seb-ma/kevin/3d-components/SKRHAD.step

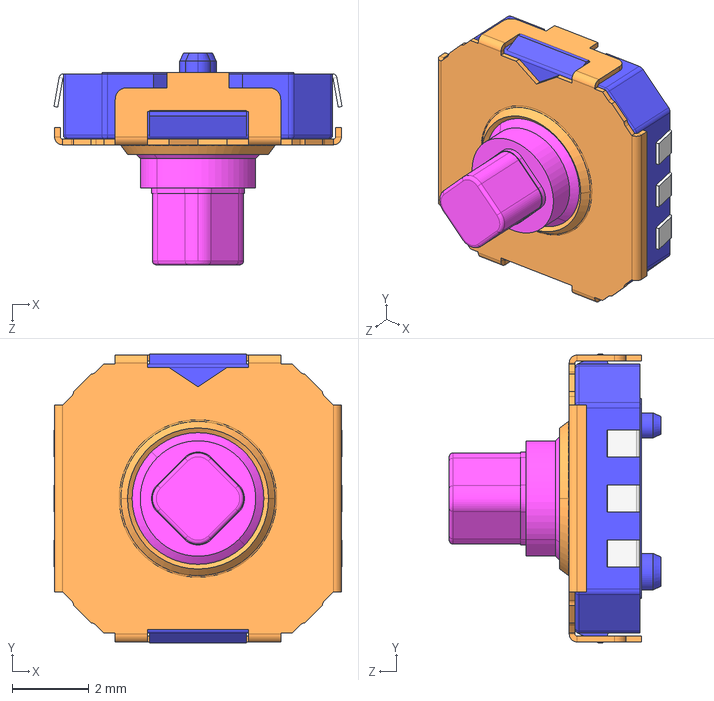
[picture p1: CAD file, 2021-09-05]
3d-components/SKRHAD.step
7.48 x 7.50 x 5.50 mm
