seb-ma/kevin/3d-components/SW_SPDT_CK-JS102011SAQN.step

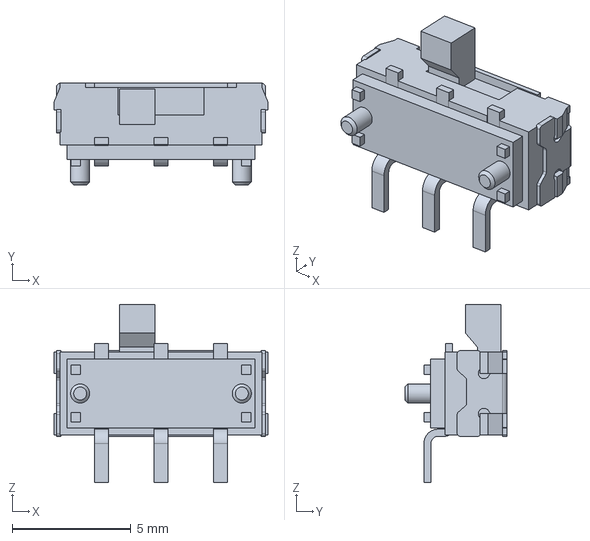
[picture p2: CAD file, 2021-09-05]
3d-components/SW_SPDT_CK-JS102011SAQN.step
9.00 x 4.30 x 7.50 mm
