seb-ma/kevin/3d-components/CON_MILL-MAX-810-22-008-40-001101.step

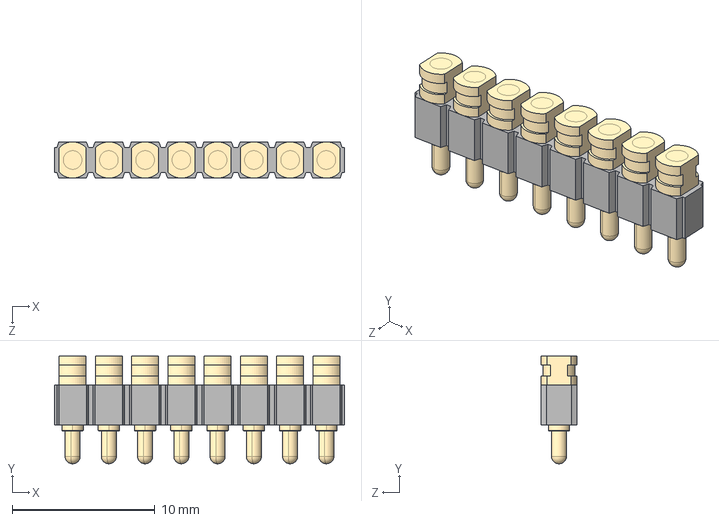
[picture p3: CAD file, 2021-09-05]
3d-components/CON_MILL-MAX-810-22-008-40-001101.step
20.3 x 7.54 x 2.54 mm
mill-max-810-22-008-40-001101_P3XX-18-010-00-090000_P308-18-010-00-090000
mill-max-810-22-008-40-001101_0916_default x 8
