seb-ma/kevin/3d-components/CON_HIROSE_FH12-30S-0_5SH_55_.step

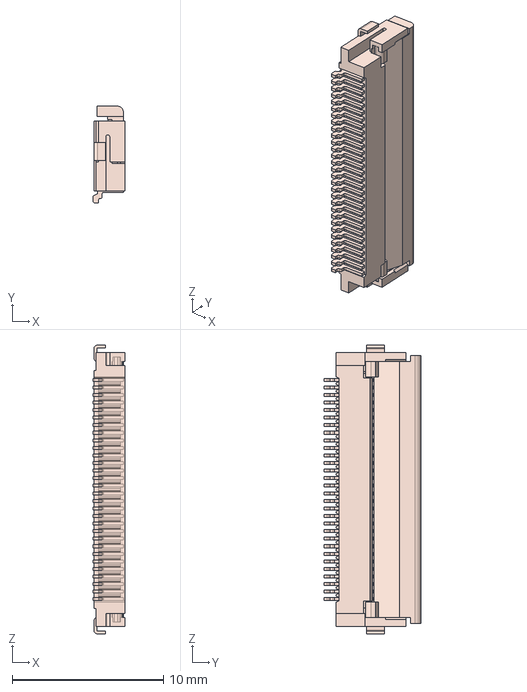
[picture p4: CAD file, 2021-09-05]
3d-components/CON_HIROSE_FH12-30S-0_5SH_55_.step
2.10 x 6.40 x 19.1 mm
