seb-ma/kevin/3d-components/CON_SM02B-SRSS-TB.step

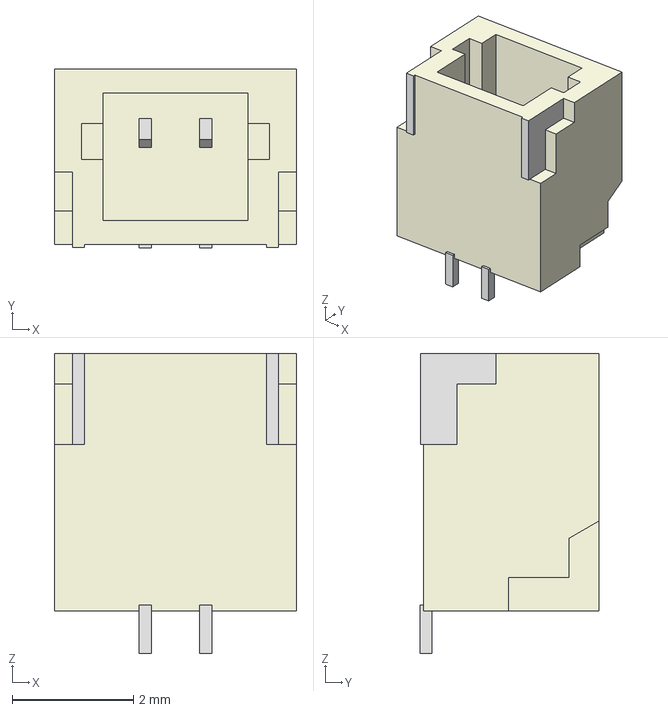
[picture p5: CAD file, 2021-09-05]
3d-components/CON_SM02B-SRSS-TB.step
4.00 x 2.96 x 4.95 mm
