seb-ma/kevin/3d-components/CON_MOLEX_2005280040.step

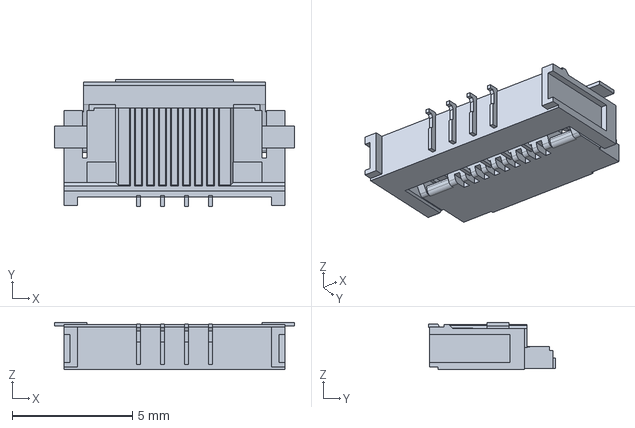
[picture p6: CAD file, 2021-09-05]
3d-components/CON_MOLEX_2005280040.step
10.0 x 5.30 x 1.96 mm
