seb-ma/kevin/3d-components/CON_MILL-MAX-319-10-108-40-080001.step

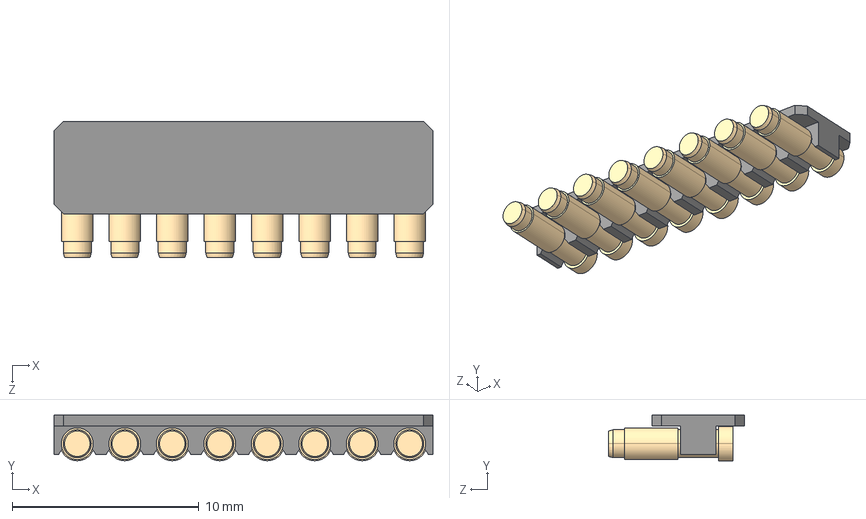
[picture p7: CAD file, 2021-09-05]
3d-components/CON_MILL-MAX-319-10-108-40-080001.step
20.3 x 2.44 x 7.29 mm
mill-max-319-10-108-40-080001_P8XX-18-083-00-400155_P808-18-083-00-400155
mill-max-319-10-108-40-080001_1980_1980-0-00-15-00-00-03-0 x 8
