seb-ma/kevin/(commit log)

2021-07-27 First commit to share
    [kevin.kicad_pcb, kevin.sch]
2021-07-30 Prepare reversible matrix (kailth pg1350 and diode footprints) Routing e-ink reset to mcu Keys placement
    [kevin.kicad_pcb, kevin.sch]
2021-07-31 General cleaning
    [kevin.kicad_pcb, kevin.sch]
2021-08-19 prepare schema for review
    [kevin.kicad_pcb, kevin.sch]
2021-08-22 minor correction on schematic layout + first attempt to route traces
    [kevin.kicad_pcb, kevin.sch]
2021-08-24 footprints work auto-routing traces
    [kevin.kicad_pcb, kevin.sch]
2021-08-25 Adding reversible footprints and initialize readme
    [kevin.kicad_pcb, kevin.sch]
2021-08-29 Adjust components (battery footprint, JSR, corrections) Add temporary BOM Correction of battery component (remove kicad complaint)
    [kevin.kicad_pcb, kevin.sch]
2021-08-31 Adding millmax connectors, submodule (kailh 3D, promicro 3D), screen
    [kevin.kicad_pcb, kevin.sch]
2021-09-03 Adding mechanical scheme Moving components to reduce PCB size
    [kevin.kicad_pcb, kevin.sch, mechanical.sch]
2021-09-05 Adding 3D view of components Correction on mill-max size (mills/mm) Changing resistor to 0805 (like capacitors) Separation of GND and VCC on mill-max connectors to avoid shortcuts
    [CON_HIROSE_FH12-30S-0_5SH_55_.stp, CON_MILL-MAX-319-10-108-40-080001.step, CON_MILL-MAX-810-22-008-40-001101.step, CON_MOLEX_2005280040.stp, CON_SM02B-SRSS-TB.step, SKRHAD.STEP, SW_SPDT_CK-JS102011SAQN.stp, kevin.kicad_pcb]
2021-09-05 Moving 3D components directory
    [CON_HIROSE_FH12-30S-0_5SH_55_.step, CON_MILL-MAX-319-10-108-40-080001.step, CON_MILL-MAX-810-22-008-40-001101.step, CON_MOLEX_2005280040.step, CON_SM02B-SRSS-TB.step, SKRHAD.step, SW_SPDT_CK-JS102011SAQN.step, kevin.kicad_pcb]
